michaelhmt/LED_Glasses/(commit log)

2017-03-21 added Arduino code for LED googles controlled by voice volume.
2017-03-26 removed code from wrong folder
    [Glasses_V2.ino]
